Nick-VanEssen/pnw-ova/HARDWARE/README.md

# HARDWARE 
Sensors:

Accelerometer: ADXL345    
    
Microphone: SPH0645

Microprocessor/Bluetooth and WiFi Module:  ESP32-WROOM-32D

USB Bridge controller: CP2102 USB to UART
