Nick-VanEssen/pnw-ova/HARDWARE/DE429_001_INSTALL.kicad_pcb

## KiCad design HARDWARE/DE429_001_INSTALL.kicad_pcb (2024-04-24)

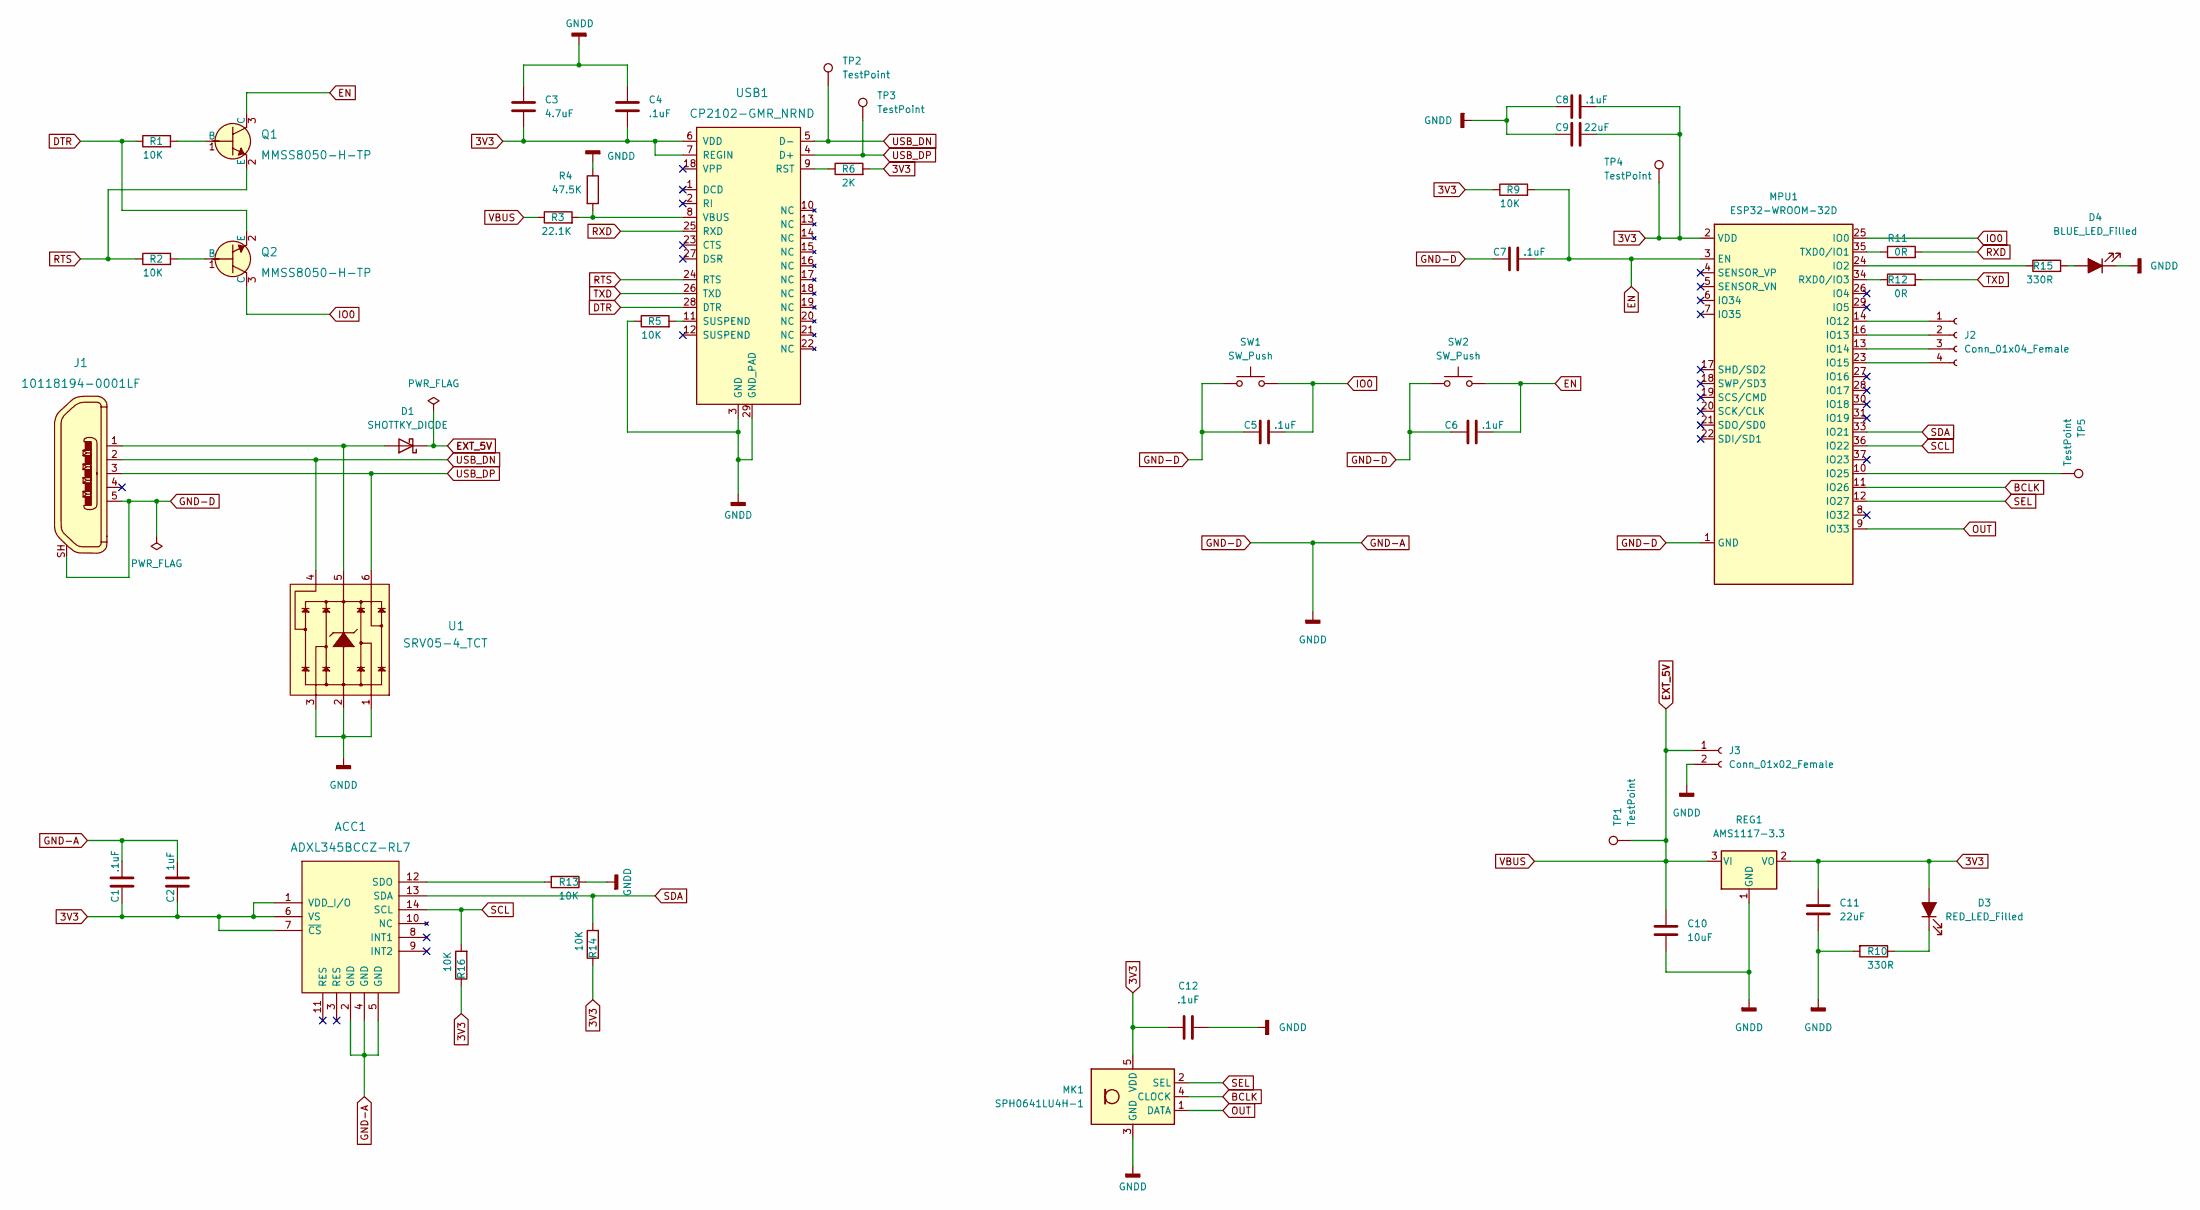
[picture p1: schematic DE429_001_INSTALL.kicad_sch, OPEN VIBRATION CIRCUIT SCHEMATIC LAYOUT]

Parts:
ACC1: ADXL345BCCZ-RL7; LGA-14_3x5mm_RevA; MPN ADXL345BCCZ-RL7; Digi-Key_PN ADXL345BCCZ-RL7CT-ND
C1, C4, C5, C6, C7, C8, C12: .1uF; C_0603_1608Metric
C2: 1uF; C_0603_1608Metric
C3: 4.7uF; C_0603_1608Metric
C9, C11: 22uF; C_0603_1608Metric
C10: 10uF; C_0603_1608Metric
D1: SHOTTKY_DIODE; D_SMA
D3: RED_LED_Filled; LED_0603_1608Metric
D4: BLUE_LED_Filled; LED_0603_1608Metric
J1: 10118194-0001LF; USB_Micro_B_Female_10118194-0001LF; MPN 10118194-0001LF; Digi-Key_PN 609-4618-1-ND
J2: Conn_01x04_Female; JST_XH_B4B-XH-AM_1x04_P2.50mm_Vertical
J3: Conn_01x02_Female; JST_XH_B2B-XH-AM_1x02_P2.50mm_Vertical
MK1: SPH0641LU4H-1; Knowles_LGA-5_3.5x2.65mm
MPU1: ESP32-WROOM-32D; ESP32-WROOM-32
Q1, Q2: MMSS8050-H-TP; SOT-23-3; MPN MMSS8050-H-TP; Digi-Key_PN MMSS8050-H-TPMSCT-ND
R1, R2, R5, R9, R13, R14, R16: 10K; R_0603_1608Metric
R3: 22.1K; R_0603_1608Metric
R4: 47.5K; R_0603_1608Metric
R6: 2K; R_0603_1608Metric
R10, R15: 330R; R_0603_1608Metric
R11, R12: 0R; R_0603_1608Metric
REG1: AMS1117-3.3; SOT-223-3_TabPin2
SW1, SW2: SW_Push; SW_SPST_TL3342
TP1, TP2, TP3, TP4, TP5: TestPoint; TestPoint_THTPad_D3.0mm_Drill1.5mm
U1: SRV05-4_TCT; SOT-23-6; MPN SRV05-4.TCT; Digi-Key_PN SRV05-4CT-ND
USB1: CP2102-GMR_NRND; VFQFN-28-1EP_5x5mm; MPN CP2102-GMR; Digi-Key_PN 336-1160-1-ND

Connections:
3V3: ACC1.1 (VDD_I/O), ACC1.6 (VS), ACC1.7 (~CS), C1.1, C2.1, C3.2, C4.2, C8.1, C9.1, C11.1, C12.1, D3.2 (A), MK1.5 (VDD), MPU1.2 (VDD), R6.2, R9.1, R14.1, R16.1, REG1.2 (VO), TP4.1, USB1.6 (VDD), USB1.7 (REGIN)
BCLK: MK1.4 (CLOCK), MPU1.11 (IO26)
DTR: Q2.2 (E), R1.1, USB1.28 (DTR)
EN: C6.2, C7.2, MPU1.3 (EN), Q1.3 (C), R9.2, SW2.2
EXT_5V: C10.1, D1.1 (K), J3.1, R3.1, REG1.3 (VI), TP1.1; also elsewhere on the board
GND-A: ACC1.2 (GND), ACC1.4 (GND), ACC1.5 (GND), C1.2, C2.2, C3.1, C4.1, C5.1, C6.1, C7.1, C8.2, C9.2, C10.2, C11.2, C12.2, D4.1 (K), J1.5, J1.SH, J3.2, MK1.3 (GND), MPU1.1 (GND), MPU1.15 (GND), MPU1.38 (GND), MPU1.39 (GND), R4.1, R5.1, R10.2, R13.1, REG1.1 (GND), SW1.1, SW2.1, U1.1, U1.2, U1.3, USB1.3 (GND), USB1.29 (GND_PAD)
IO0: C5.2, MPU1.25 (IO0), Q2.3 (C), SW1.2
unnamed: ACC1.12 (SDO), R13.2
unnamed 8: D1.2 (A), J1.1, U1.5; also elsewhere on the board
unnamed: D3.1 (K), R10.1
unnamed: D4.2 (A), R15.2
unnamed: J2.1, MPU1.14 (IO12)
unnamed: J2.2, MPU1.16 (IO13)
unnamed: J2.3, MPU1.13 (IO14)
unnamed: J2.4, MPU1.23 (IO15)
unnamed: MPU1.10 (IO25), TP5.1
unnamed: MPU1.24 (IO2), R15.1
unnamed: MPU1.34 (RXD0/IO3), R12.1
unnamed: MPU1.35 (TXD0/IO1), R11.1
unnamed: Q1.1 (B), R1.2
unnamed: Q2.1 (B), R2.2
unnamed: R3.2, R4.2, USB1.8 (VBUS)
unnamed: R5.2, USB1.11 (SUSPEND)
unnamed: R6.1, USB1.9 (RST)
OUT: MK1.1 (DATA), MPU1.9 (IO33)
RTS: Q1.2 (E), R2.1, USB1.24 (RTS)
RXD: R11.2, USB1.25 (RXD)
SCL: ACC1.14 (SCL), MPU1.36 (IO22), R16.2
SDA: ACC1.13 (SDA), MPU1.33 (IO21), R14.2
SEL: MK1.2 (SEL), MPU1.12 (IO27)
TXD: R12.2, USB1.26 (TXD)
USB_DN: J1.2, TP2.1, U1.4, USB1.5 (D-)
USB_DP: J1.3, TP3.1, U1.6, USB1.4 (D+)

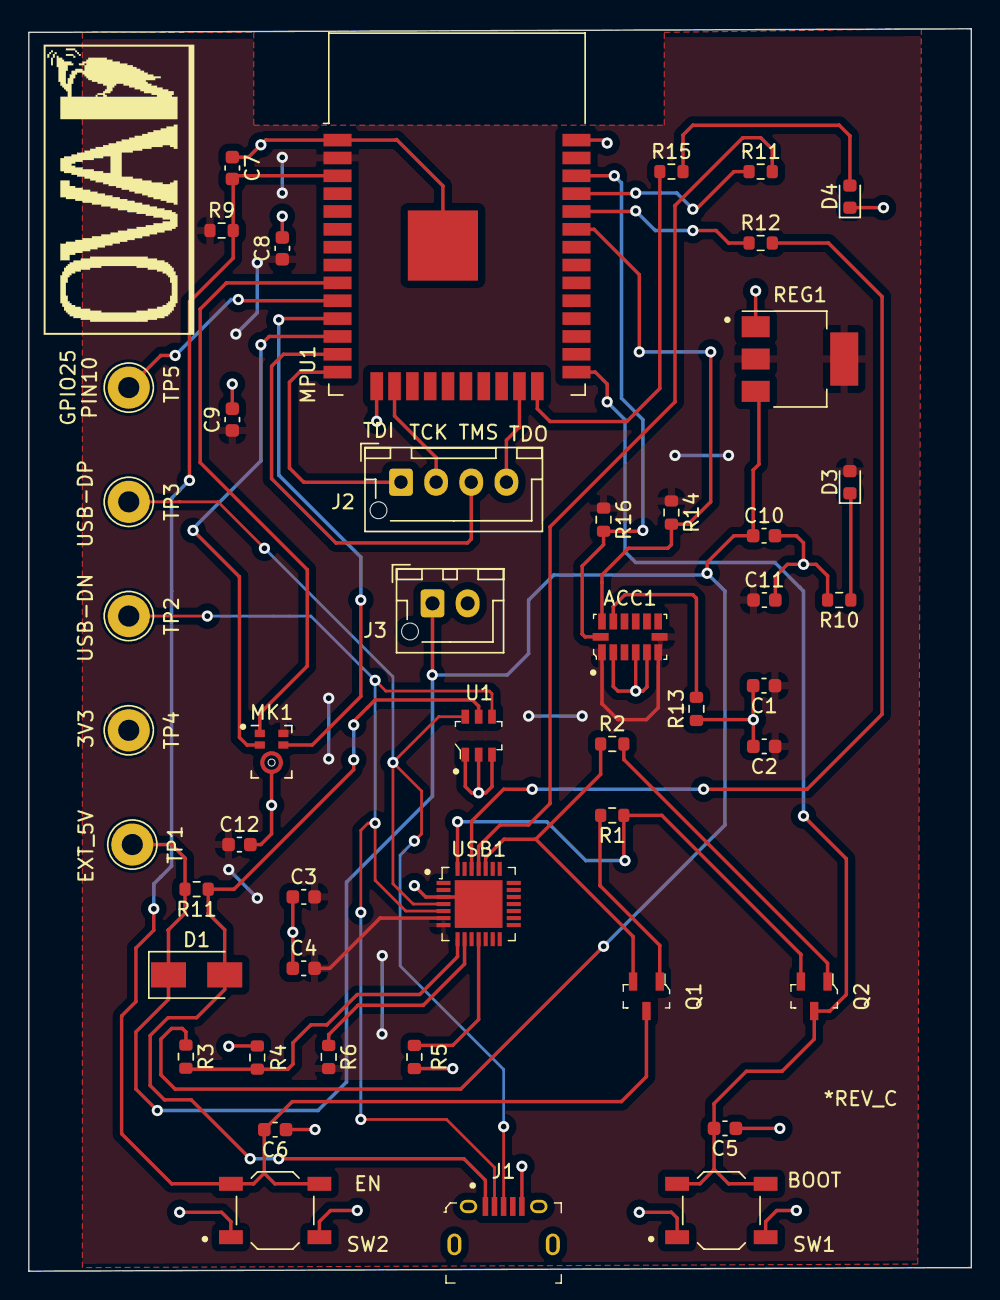
[picture p2: board DE429_001_INSTALL.kicad_pcb from above]

Board: 2 copper layers, 67.1 x 88.4 mm, 48 parts (0 on the bottom side), 33 nets.

Other parts of the board:
R11#2: 2K; R_0603_1608Metric

Their connections:
EXT_5V: R11#2.2; also elsewhere on the board
unnamed 8: R11#2.1; also elsewhere on the board
