Nick-VanEssen/pnw-ova/CHANGELOG.md

# Changelog
All notable changes to this project will be documented in this file.

The format is based on [Keep a Changelog](https://keepachangelog.com/en/1.0.0/)
and this project adheres to [Semantic Versioning](https://semver.org/spec/v2.0.0.html).
## [Unreleased]
### Added
- Added Header Files.
- Added CHANGELOG.md
- Added gitignore to root of project. 
- Added LED diagnostic to PDM Mic.
- Added memory debugging.
- Added PDM mic task. 

### Changed
- Moved some static assigns to header files.
- Removed "progmem" as it's not relevant to ESP32.
- Added a fixed version of the platform in platformio.ini.

### Hardware
