Nick-VanEssen/pnw-ova/CHANGELOG1.md

# Changelog
All notable changes to this project will be documented in this file.

The format is based on [Keep a Changelog](https://keepachangelog.com/en/1.0.0/)
and this project adheres to [Semantic Versioning](https://semver.org/spec/v2.0.0.html).

## [Unreleased]

### Added

# 11/27/2022 
New updates to the PCB Schematics were done.

### Changed

# 11/27/2022
Changed the mircophone to a Ziltek ZTS6117 mircophone in order to have all components printed on the PCB.
