Nick-VanEssen/pnw-ova/include/main.h

#pragma once //prevent file from being included more than once
#include <chrono>
using namespace std;
using namespace std::chrono;

/* *************** DECLARE FUNCTIONS HERE *************** */
high_resolution_clock::time_point getStartTime();
