Nick-VanEssen/pnw-ova/(commit log)

2023-10-04 feat: add last years files
    Adds the files from last years repo
    [DE429_001_INSTALL.kicad_pcb, DE429_001_INSTALL.kicad_sch]
2023-10-04 feat: Added ESP32 web server code
2023-10-04 Added header files
    ### Added
    - Added Header Files
    - Added CHANGELOG.md
    - Added gitignore to root of project.
    ### Changed
    - Moved some static assigns to header files.
    - Removed "progmem" as it's not required with ESP32.
    - Added a fixed version of the platform in platformio.ini.
    [main.cpp, main.h]
2023-10-05 feat/ created access point
    Created the access point that we will eventually use to connect the ESP32 to wifi
2023-10-19 Folder Maintenance
    [DE429_001_INSTALL.kicad_pcb, DE429_001_INSTALL.kicad_sch]
2023-10-19 fix: esp restart error
    [main.cpp]
2023-11-07 attempting to get old board data going
2023-11-07 fixed header issues, working on timing system
    [FFT.h, acc.cpp, acc.h, fft.cpp, main.cpp, main.h]
2023-11-09 Code fix and cleanup
    [main.cpp]
2023-11-09 fix: header files and code maintainability
    [email.cpp, main.cpp, settings.h]
2023-11-10 restructure a bit and looked at arduinofft library
2023-11-27 fix: email send on every run
    [main.cpp]
2023-11-27 work with arduinoFFT
2023-11-30 work on printing fft
2023-12-04 feat: web server and graph
    [freq_amp.csv]
2023-12-04 attempting to fix tasks
    [acc.cpp, fft.cpp, settings.h]
2023-12-06 changed FFT to not a task and worked on mag problem
    [FFT.h, acc.cpp, fft.cpp, main.cpp]
2023-12-06 attempt to fix illegalinstruction error
    [FFT.h, acc.cpp, main.cpp, pdm_mic.cpp]
2023-12-06 FIXED THE MAGNITUDE GOING TO OVF WOOOOOOOOOOOOOO
    [fft.cpp]
2023-12-07 feat: half of websocket implementation
    [freq_amp.csv]
2024-02-02 global variables updated correctly
    [acc.cpp, fft.cpp, main.cpp, monitor.cpp, pdm_mic.cpp, settings.h]
2024-02-09 websocket stuff. broken rn
    [fft.cpp, main.cpp]
2024-02-23 Remove Arduino String
2024-03-28 Default email to fix crashing if null
    [main.cpp]
2024-04-04 stop start button
2024-04-04 remove heap print
